natagoh/EE372B/ee372b-ldo-testbench/ee372b-ldo-testbench_20261005_030430/stencil_front.3mf

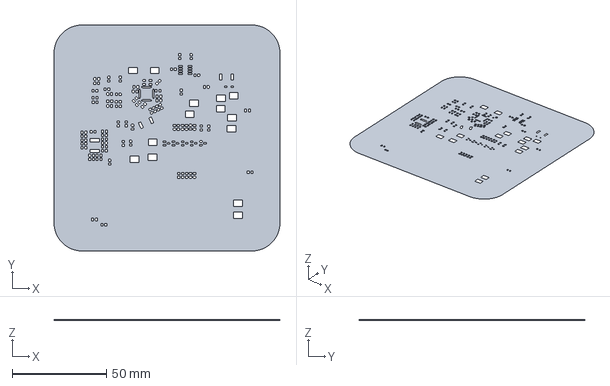
[picture p1: CAD file, 2026-10-05]
ee372b-ldo-testbench/ee372b-ldo-testbench_20261005_030430/stencil_front.3mf
120.0 x 120.0 x 0.2 mm
