natagoh/EE372B/parts/ADS1220IPW/ADS1220IPW.step

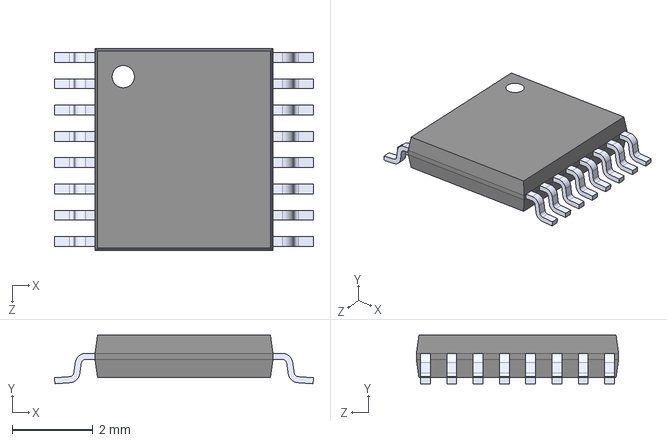
[picture p2: CAD file, 2026-10-04]
parts/ADS1220IPW/ADS1220IPW.step
6.40 x 1.20 x 5.00 mm
