natagoh/EE372B/parts/MMSZ4679T1G/SOD-123_ONS.step

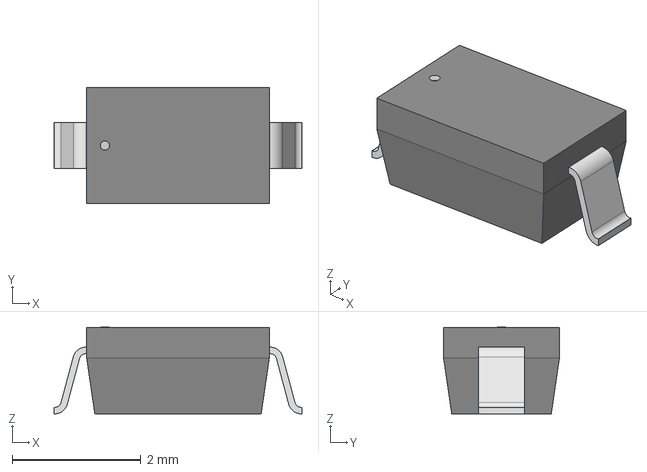
[picture p3: CAD file, 2026-10-04]
parts/MMSZ4679T1G/SOD-123_ONS.step
3.86 x 1.80 x 1.35 mm
