natagoh/EE372B/parts/PEC03SAAN/CONN_PEC03SAAN_SUL.step

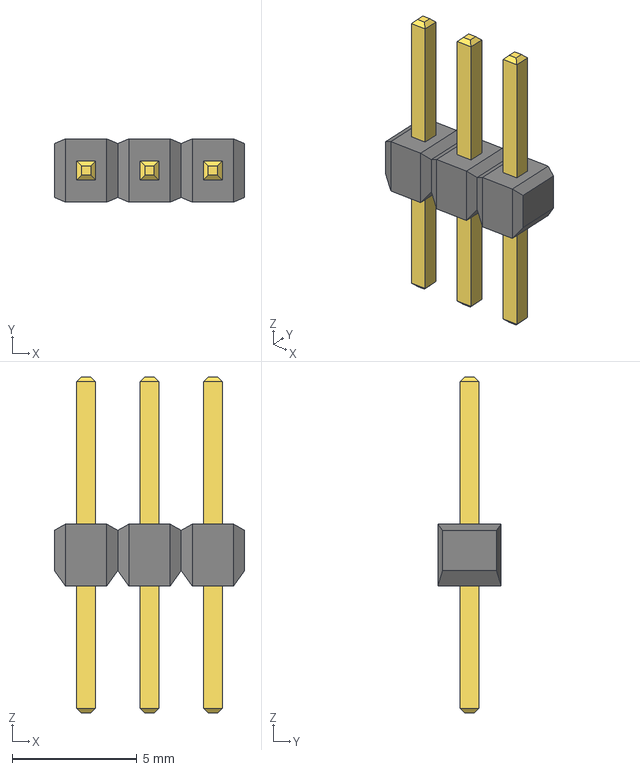
[picture p4: CAD file, 2026-10-04]
parts/PEC03SAAN/CONN_PEC03SAAN_SUL.step
7.62 x 2.54 x 13.5 mm
