natagoh/EE372B/(list of files, cad)

Other CAD files:
ee372b-ldo-testbench/stencil/ee372b-ldo-testbench_20261005_031027/stencil_front.3mf
ee372b-ldo-testbench/ee372b-ldo-testbench_20261005_030430/stencil_front.stl
ee372b-ldo-testbench/stencil/ee372b-ldo-testbench_20261005_031027/stencil_front.stl
