natagoh/EE372B/ee372b-ldo-testbench.pdf

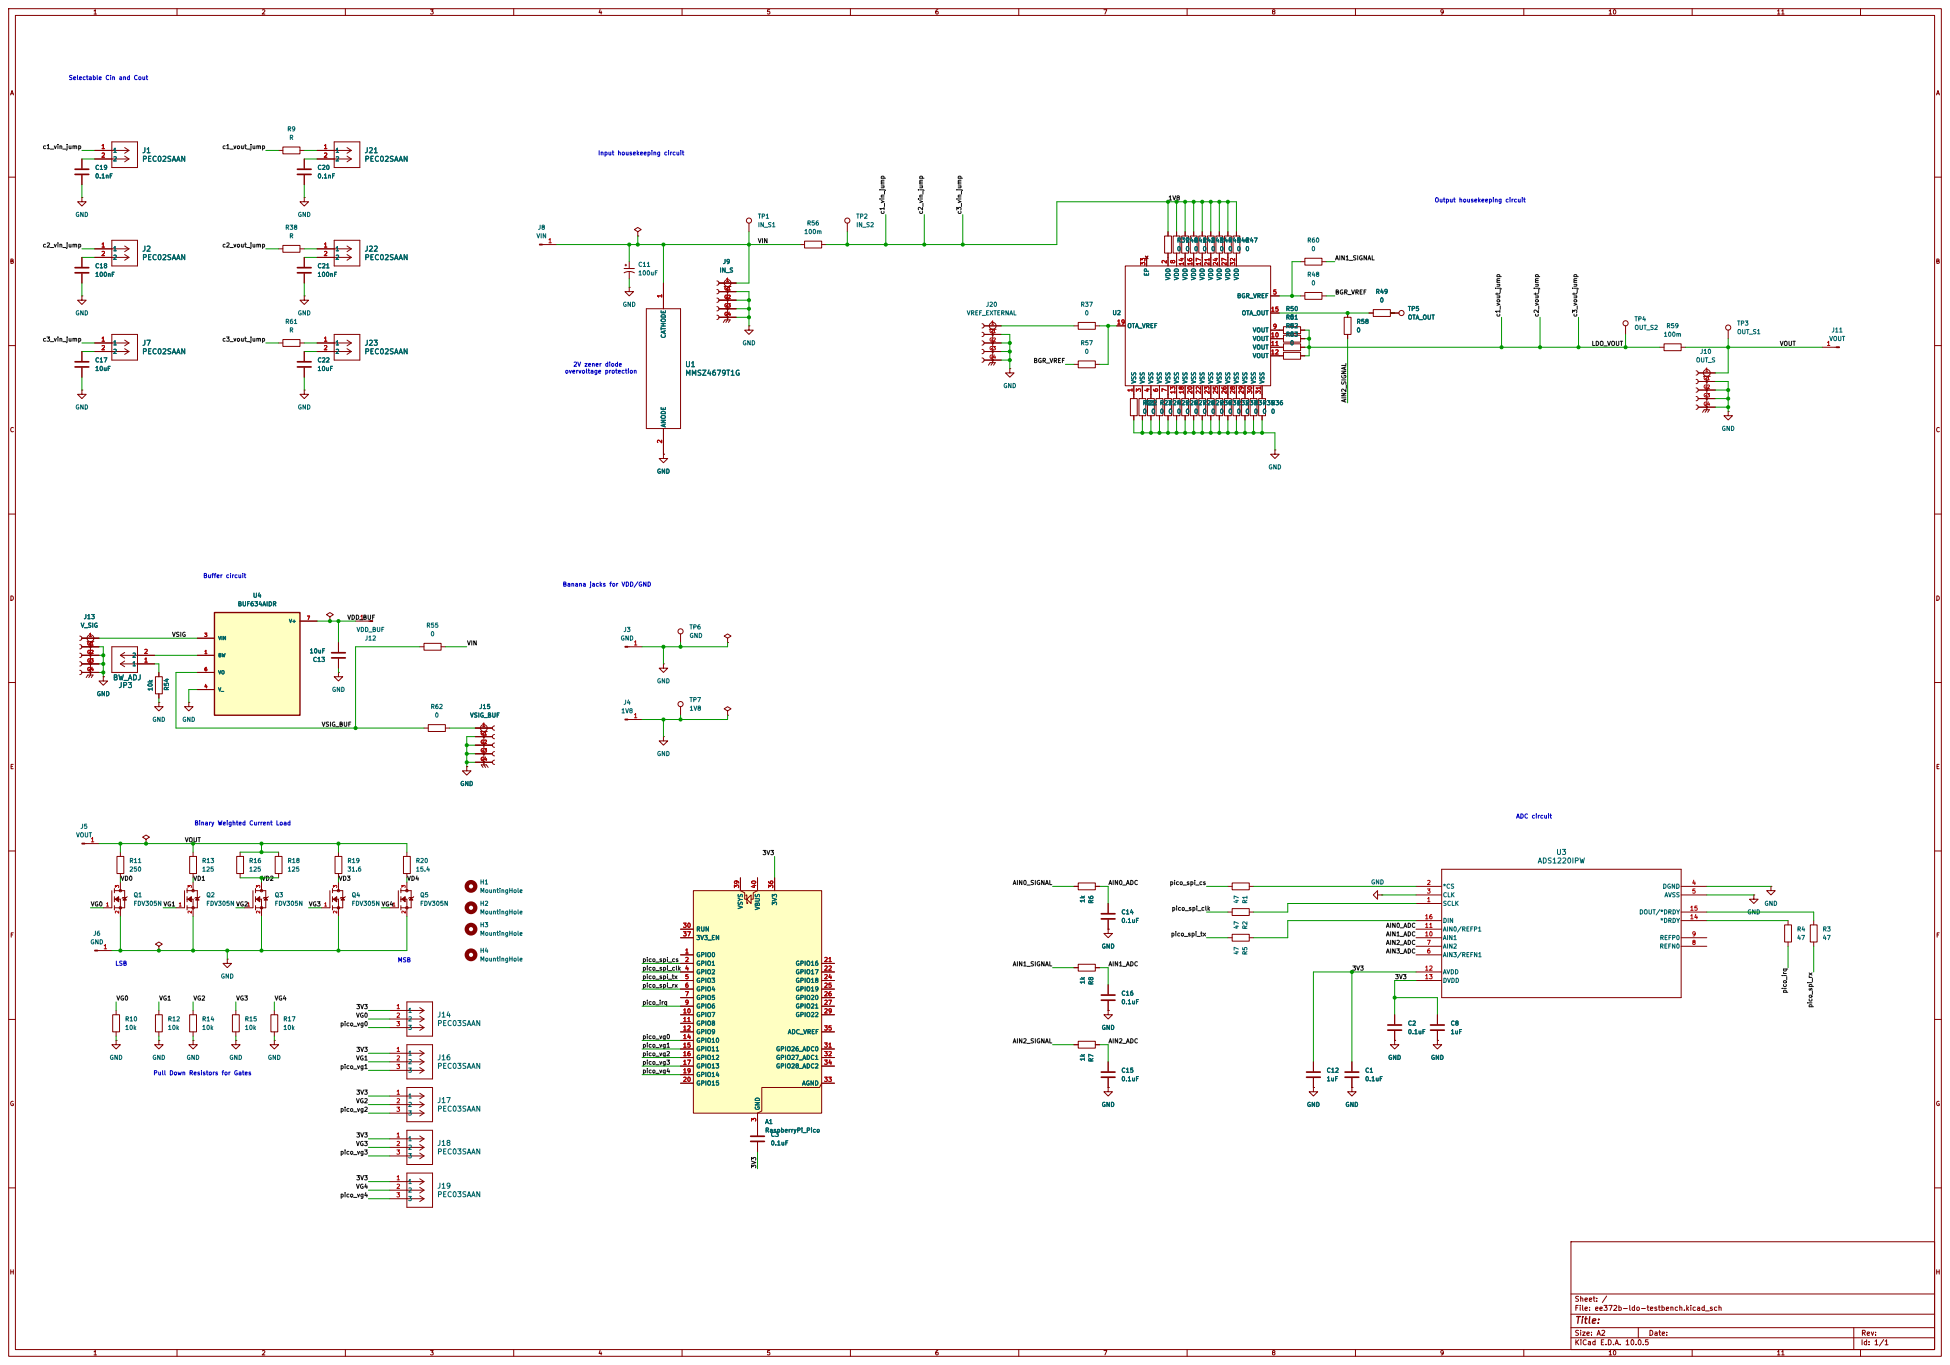
[picture p5: page 1]

Output housekeeping circuit Selectable Cin and Cout

2V zener diode overvoltage protection C19

Banana jacks for VDD/GND

3V3 Binary Weighted Current Load

Size: A2 | Rev:
KiCad E.D.A. 10.0.5 | Id: 1/1
