natagoh/EE372B/ee372b-ldo-testbench/ee372b-ldo-testbench.kicad_pcb

## KiCad design ee372b-ldo-testbench/ee372b-ldo-testbench.kicad_pcb (2026-11-07)

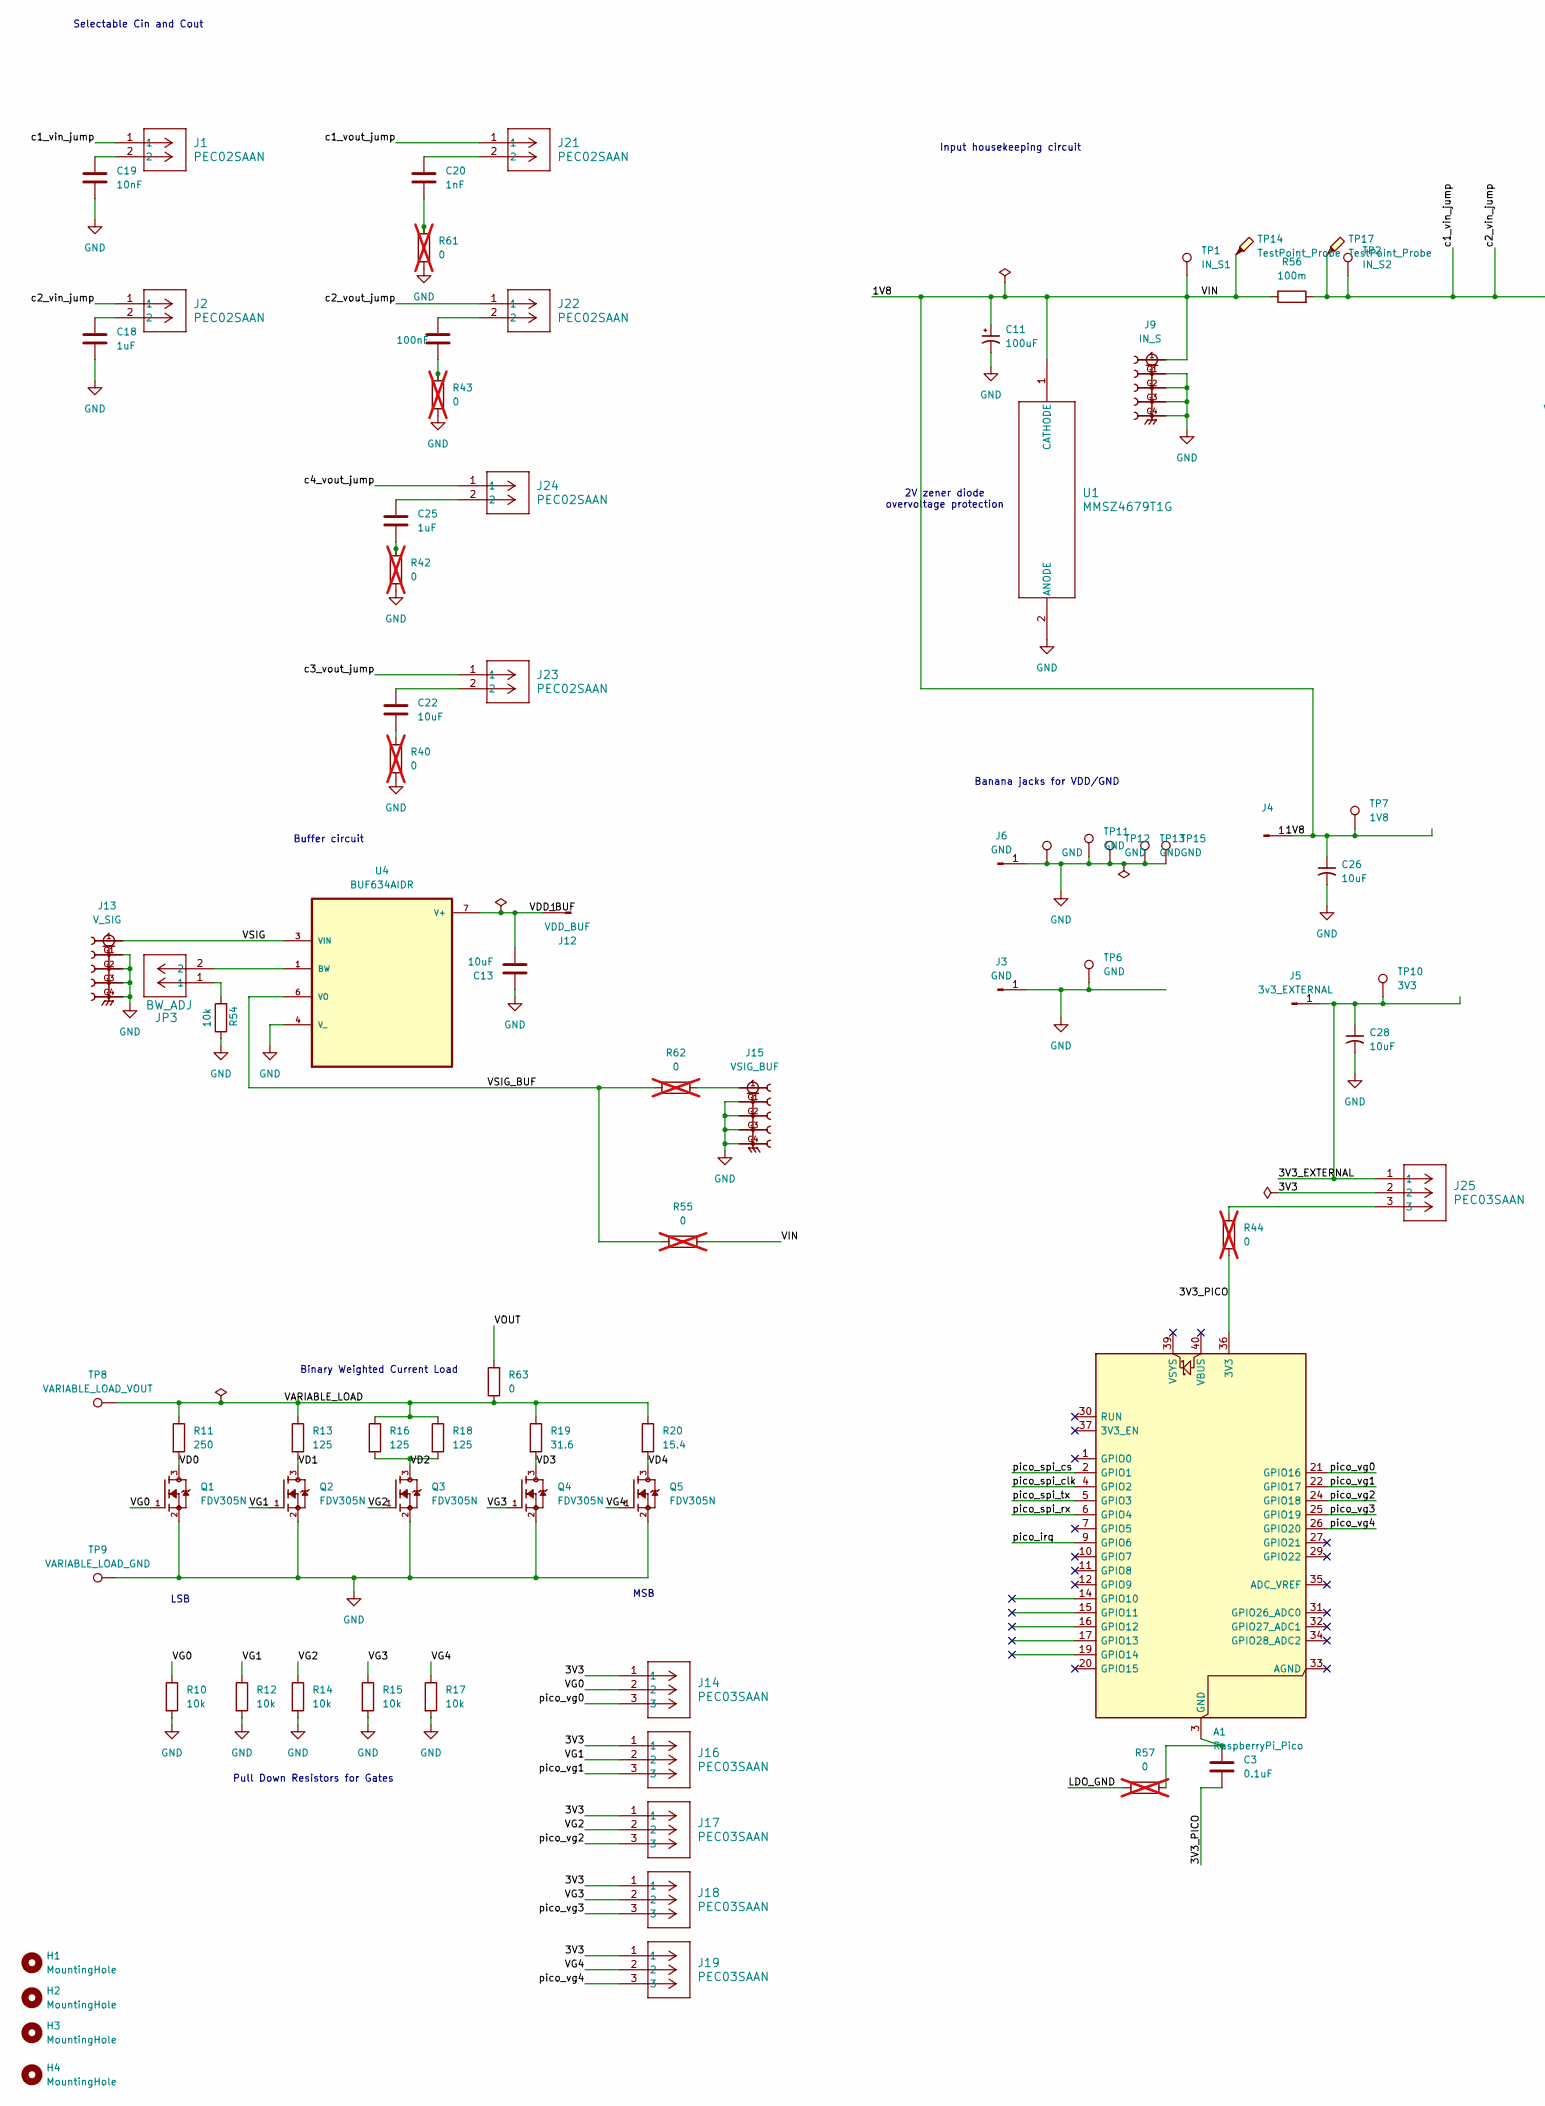
[picture p6: schematic ee372b-ldo-testbench.kicad_sch, part in row 1, column 1]

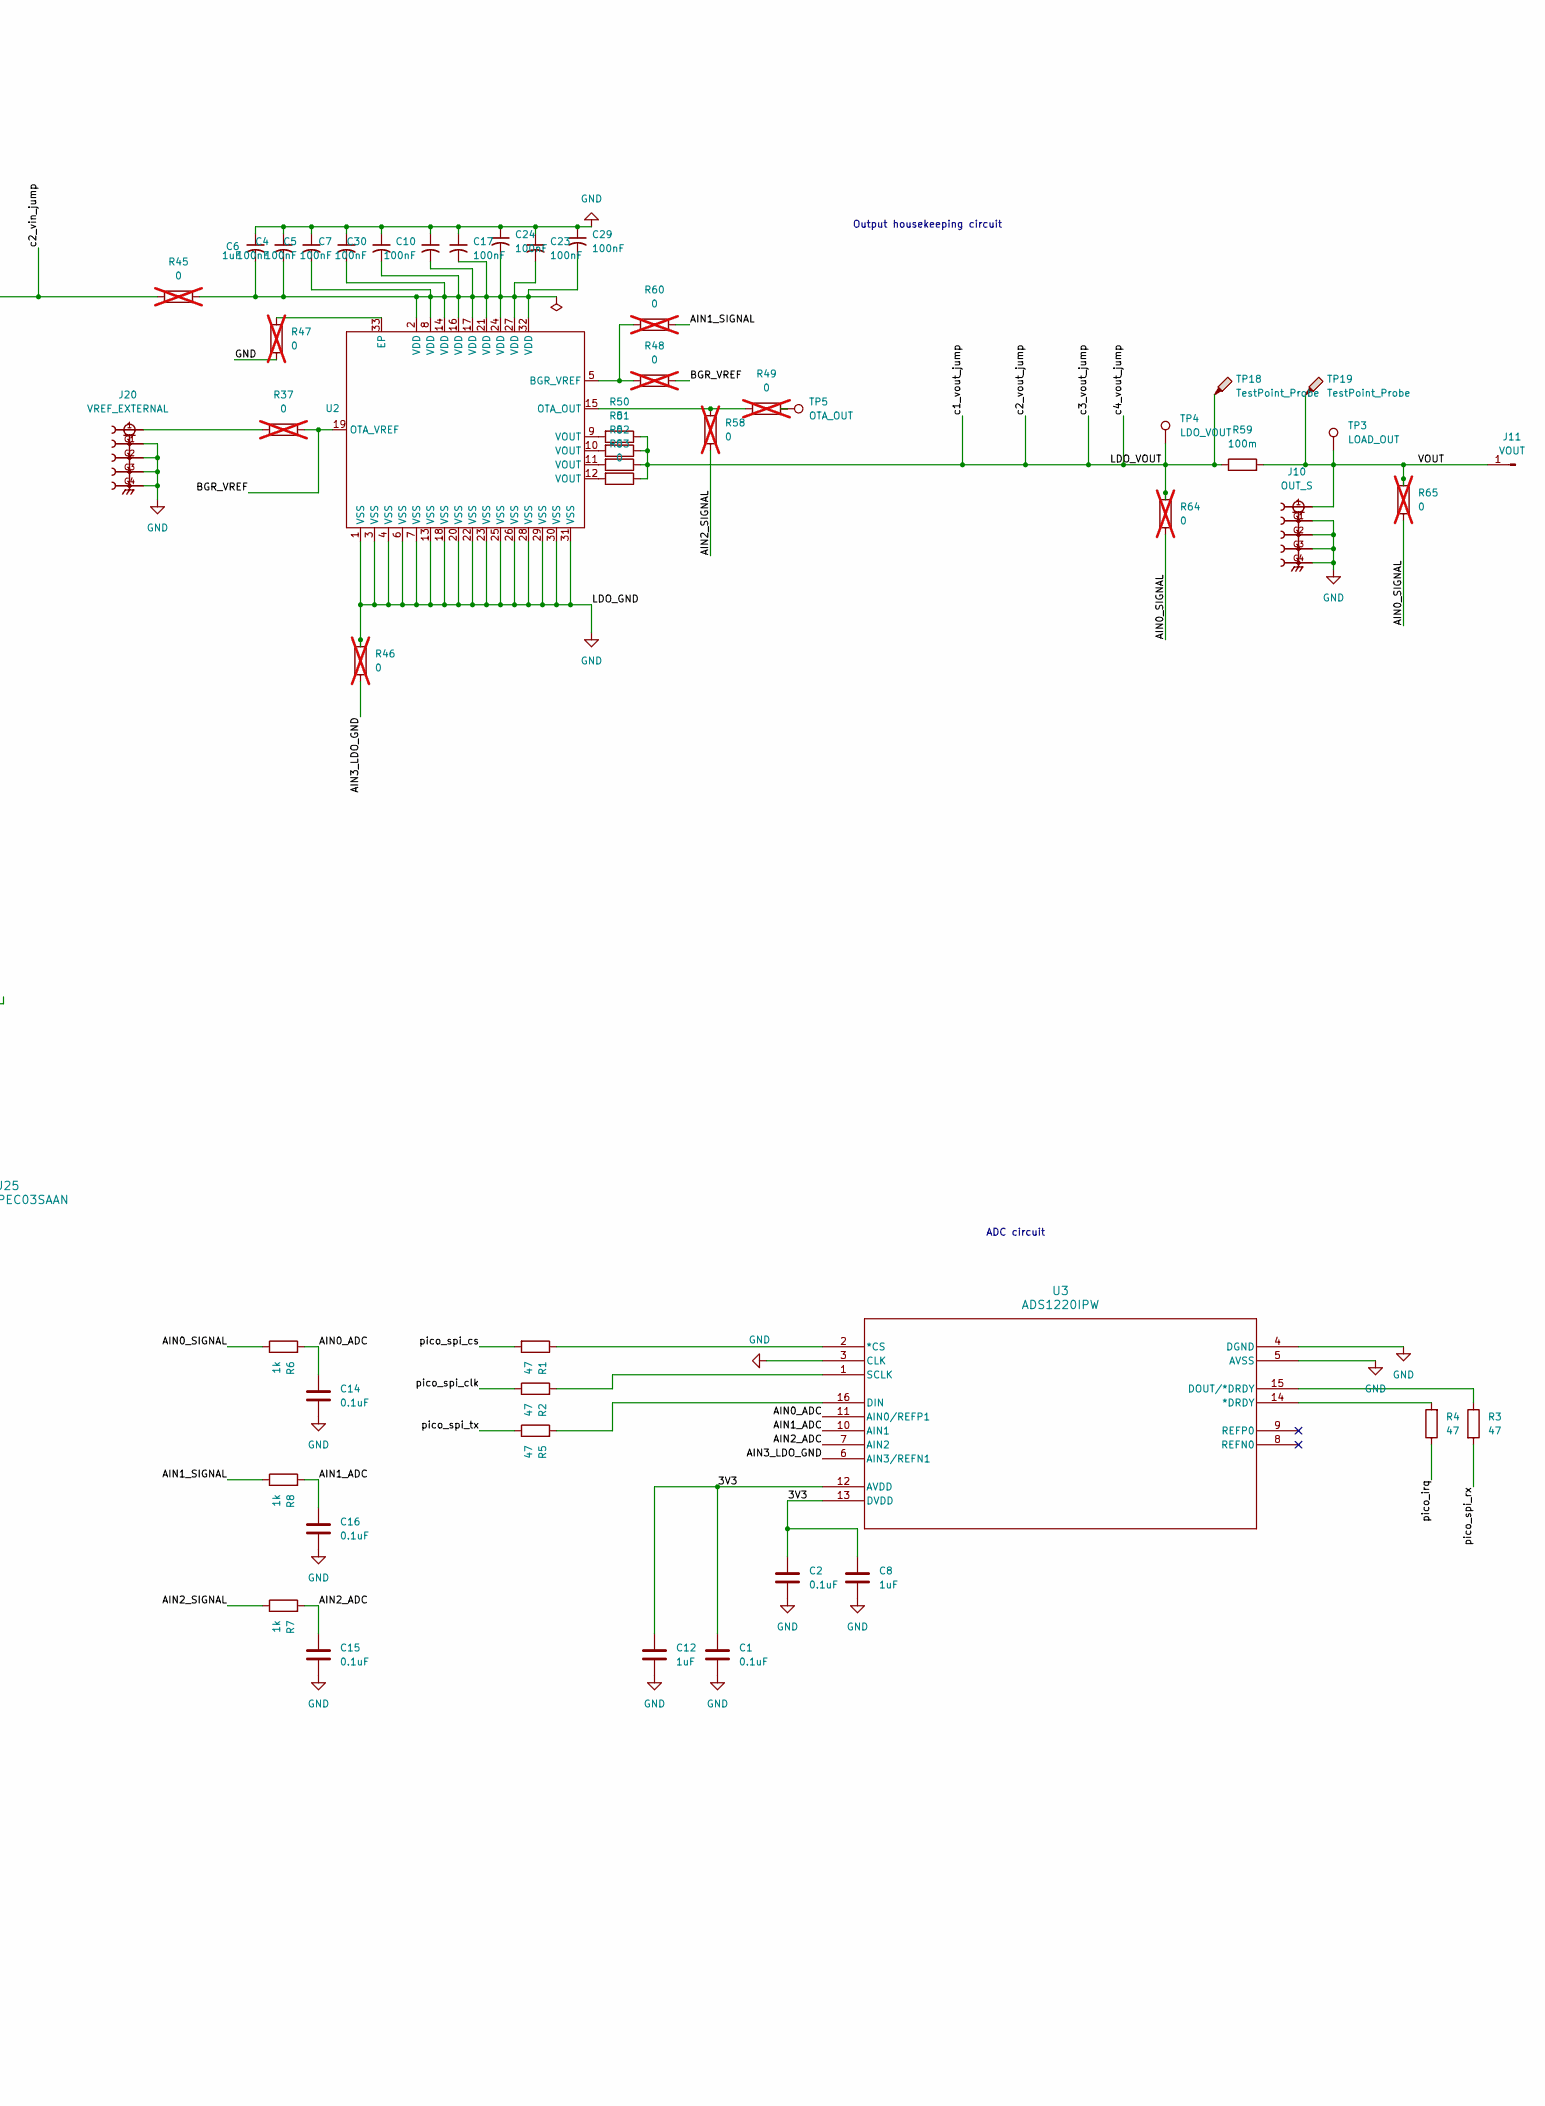
[picture p7: schematic ee372b-ldo-testbench.kicad_sch, part in row 1, column 2]

Parts:
A1: RaspberryPi_Pico; RaspberryPi_Pico_Common_Unspecified
C1, C2, C3, C14, C15, C16: 0.1uF; C_0805_2012Metric_Pad1.18x1.45mm_HandSolder
C4, C5, C7, C10, C17, C23, C24, C29, C30: 100nF; C_0805_2012Metric_Pad1.18x1.45mm_HandSolder
C6, C8, C12: 1uF; C_0805_2012Metric_Pad1.18x1.45mm_HandSolder
C11: 100uF; CAPPRD350W60D800H1150; Manufacturer Part Number EEU-FC1V101
C13, C22: 10uF; C_0805_2012Metric_Pad1.18x1.45mm_HandSolder; Manufacturer Part Number C0805C106K8RACTU
C18, C25: 1uF; C_0805_2012Metric_Pad1.18x1.45mm_HandSolder; Manufacturer Part Number C0805C104K8RACTU
C19: 10nF; C_0805_2012Metric_Pad1.18x1.45mm_HandSolder; Manufacturer Part Number C0805C101K8RACTU
C20: 1nF; C_0805_2012Metric_Pad1.18x1.45mm_HandSolder; Manufacturer Part Number C0805C101K8RACTU
C21: 100nF; C_0805_2012Metric_Pad1.18x1.45mm_HandSolder; Manufacturer Part Number C0805C104K8RACTU
C26, C28: 10uF; C_0805_2012Metric_Pad1.18x1.45mm_HandSolder
H1, H2, H3, H4: MountingHole; MountingHole_2.5mm
J1, J2, J21, J22, J23, J24: PEC02SAAN; CONN_PxC02S_SUL
J3, J6: GND; CALTEST_CT3151-2; Manufacturer Part Number CT3151SP-0
J4: 1V8; CALTEST_CT3151-2; Manufacturer Part Number CT3151SP-0
J5: 3v3_EXTERNAL; CALTEST_CT3151-2; Manufacturer Part Number CT3151SP-0
J9: IN_S; SAMTEC_SMA-J-P-H-ST-TH1; Manufacturer Part Number SMA-J-P-H-ST-TH1
J10: OUT_S; SAMTEC_SMA-J-P-H-ST-TH1; Manufacturer Part Number SMA-J-P-H-ST-TH1
J11: VOUT; CALTEST_CT3151-2; Manufacturer Part Number CT3151SP-6
J12: VDD_BUF; CALTEST_CT3151-2; Manufacturer Part Number CT3151SP-2
J13: V_SIG; SAMTEC_SMA-J-P-H-ST-TH1; Manufacturer Part Number SMA-J-P-H-ST-TH1
J14, J16, J17, J18, J19, J25: PEC03SAAN; CONN_PEC03SAAN_SUL
J15: VSIG_BUF; SAMTEC_SMA-J-P-H-ST-TH1; Manufacturer Part Number SMA-J-P-H-ST-TH1
J20: VREF_EXTERNAL; SAMTEC_SMA-J-P-H-ST-TH1; Manufacturer Part Number SMA-J-P-H-ST-TH1
JP3: BW_ADJ; CONN_PxC02S_SUL; Manufacturer Part Number PEC02SAAN
Q1, Q2, Q3, Q4, Q5: FDV305N; SOT95P240X111-3N; Manufacturer Part Number FDV305N
R1, R2, R3, R4, R5: 47; R_0805_2012Metric_Pad1.20x1.40mm_HandSolder
R6, R7, R8: 1k; R_0805_2012Metric_Pad1.20x1.40mm_HandSolder
R10, R12, R14, R15, R17, R54: 10k; R_0805_2012Metric_Pad1.20x1.40mm_HandSolder; Manufacturer Part Number RC0805FR-0710KL
R11: 250; R_0805_2012Metric_Pad1.20x1.40mm_HandSolder; Manufacturer Part Number RQ73C2A249RBTD
R13, R16, R18: 125; R_0805_2012Metric_Pad1.20x1.40mm_HandSolder; Manufacturer Part Number RQ73C2A124RBTD
R19: 31.6; R_0805_2012Metric_Pad1.20x1.40mm_HandSolder; Manufacturer Part Number RQ73C2A31R6BTD
R20: 15.4; R_0805_2012Metric_Pad1.20x1.40mm_HandSolder; Manufacturer Part Number RQ73C2A15R4BTDF
R37, R40, R42, R43, R44, R45, R46, R47, R48, R49, R58, R60, R61, R64, R65: 0; R_0805_2012Metric_Pad1.20x1.40mm_HandSolder; not fitted
R50, R51, R52, R53: 0; R_0805_2012Metric_Pad1.20x1.40mm_HandSolder
R55, R57, R62: 0; R_0805_2012Metric_Pad1.20x1.40mm_HandSolder; Manufacturer Part Number CRCW08050000Z0EAHP; not fitted
R56, R59: 100m; R_2512_6332Metric_Pad1.40x3.35mm_HandSolder; Manufacturer Part Number PA2512FKE7W0R1E
R63: 0; R_0805_2012Metric_Pad1.20x1.40mm_HandSolder; Manufacturer Part Number CRCW08050000Z0EAHP
TP1: IN_S1; KEYSTONE_5016; Manufacturer Part Number 5016
TP2: IN_S2; KEYSTONE_5016; Manufacturer Part Number 5016
TP3: LOAD_OUT; KEYSTONE_5016; Manufacturer Part Number 5016
TP4: LDO_VOUT; KEYSTONE_5016; Manufacturer Part Number 5016
TP5: OTA_OUT; KEYSTONE_5016; Manufacturer Part Number 5016
TP6, TP11, TP12, TP13, TP15, TP16: GND; KEYSTONE_5016; Manufacturer Part Number 5016
TP7: 1V8; KEYSTONE_5016; Manufacturer Part Number 5016
TP8: VARIABLE_LOAD_VOUT; KEYSTONE_5016; Manufacturer Part Number 5016
TP9: VARIABLE_LOAD_GND; KEYSTONE_5016; Manufacturer Part Number 5016
TP10: 3V3; KEYSTONE_5016; Manufacturer Part Number 5016
TP14, TP17, TP18, TP19: TestPoint_Probe; TestPoint_Pad_D1.0mm
U1: MMSZ4679T1G; SOD-123_ONS
U2: QFN-32_EP_7x7_Pitch0.65mm
U3: ADS1220IPW; PW16
U4: BUF634AIDR; SOIC127P599X175-8N; Manufacturer Part Number BUF634AIDR

Connections:
/3V3: C1.1, C2.1, C8.1, C12.1, J14.1, J16.1, J17.1, J18.1, J19.1, J25.2, U3.12 (AVDD), U3.13 (DVDD)
/3V3_EXTERNAL: C28.1, J5.1 (Pin_1_1), J25.1, TP10.1 (1_1)
/3V3_PICO: A1.36 (3V3), C3.2, R44.2
/AIN0_ADC: C14.1, R6.2, U3.11 (AIN0/REFP1)
/AIN0_SIGNAL: R6.1, R64.1, R65.1
/AIN1_ADC: C16.1, R8.2, U3.10 (AIN1)
/AIN1_SIGNAL: R8.1, R60.1
/AIN2_ADC: C15.1, R7.2, U3.7 (AIN2)
/AIN2_SIGNAL: R7.1, R58.1
/AIN3_LDO_GND: R46.1, U3.6 (AIN3/REFN1)
/BGR_VREF: R37.2, R48.1, U2.19 (OTA_VREF)
/LDO_VOUT: J21.1, J22.1, J23.1, J24.1, R50.1, R51.1, R52.1, R53.1, R59.1, R64.2, TP4.1 (1_1), TP18.1 (1_1)
/VARIABLE_LOAD: R11.1, R13.1, R16.1, R18.1, R19.1, R20.1, R63.1, TP8.1 (1_1)
/VD0: Q1.3, R11.2
/VD1: Q2.3, R13.2
/VD2: Q3.3, R16.2, R18.2
/VD3: Q4.3, R19.2
/VD4: Q5.3, R20.2
/VDD_BUF: C13.2, J12.1 (Pin_1_1), U4.7 (V+)
/VG0: J14.2, Q1.1, R10.1
/VG1: J16.2, Q2.1, R12.1
/VG2: J17.2, Q3.1, R14.1
/VG3: J18.2, Q4.1, R15.1
/VG4: J19.2, Q5.1, R17.1
/VOUT: J10.1, J11.1 (Pin_1_1), R59.2, R63.2, R65.2, TP3.1 (1_1), TP19.1 (1_1)
/VSIG: J13.1, U4.3 (VIN)
/VSIG_BUF: R55.1, R62.1, U4.6 (VO)
/c1_vin_jump: J1.1, J2.1, R45.1, R56.2, TP2.1 (1_1), TP17.1 (1_1)
/pico_irq: A1.9 (GPIO6), R4.1
/pico_spi_clk: A1.4 (GPIO2), R2.1
/pico_spi_cs: A1.2 (GPIO1), R1.2
/pico_spi_rx: A1.6 (GPIO4), R3.2
/pico_spi_tx: A1.5 (GPIO3), R5.1
/pico_vg0: A1.21 (GPIO16), J14.3
/pico_vg1: A1.22 (GPIO17), J16.3
/pico_vg2: A1.24 (GPIO18), J17.3
/pico_vg3: A1.25 (GPIO19), J18.3
/pico_vg4: A1.26 (GPIO20), J19.3
GND: C1.2, C2.2, C4.1, C5.1, C6.1, C7.1, C8.2, C10.1, C11.N, C12.2, C13.1, C14.2, C15.2, C16.2, C17.1, C18.2, C19.2, C23.1, C24.1, C26.2, C28.2, C29.1, C30.1, J3.1 (Pin_1_1), J6.1 (Pin_1_1), J9.G1, J9.G2, J9.G3, J9.G4, J10.G1, J10.G2, J10.G3, J10.G4, J13.G1, J13.G2, J13.G3, J13.G4, J15.G1, J15.G2, J15.G3, J15.G4, J20.G1, J20.G2, J20.G3, J20.G4, Q1.2, Q2.2, Q3.2, Q4.2, Q5.2, R10.2, R12.2, R14.2, R15.2, R17.2, R40.1, R42.1, R43.1, R46.2, R47.1, R54.1, R57.1, R61.1, TP6.1 (1_1), TP9.1 (1_1), TP11.1 (1_1), TP12.1 (1_1), TP13.1 (1_1), TP15.1 (1_1), TP16.1, U1.2 (ANODE), U2.1 (VSS), U2.3 (VSS), U2.4 (VSS), U2.6 (VSS), U2.7 (VSS), U2.13 (VSS), U2.18 (VSS), U2.20 (VSS), U2.22 (VSS), U2.23 (VSS), U2.25 (VSS), U2.26 (VSS), U2.28 (VSS), U2.29 (VSS), U2.30 (VSS), U2.31 (VSS), U3.3 (CLK), U3.4 (DGND), U3.5 (AVSS), U4.4 (V_); also elsewhere on the board
unnamed: A1.3 (GND), A1.8 (GND), A1.13 (GND), A1.18 (GND), A1.23 (GND), A1.28 (GND), A1.38 (GND), C3.1, R57.2
unnamed: C4.2, C5.2, C6.2, C7.2, C10.2, C17.2, C23.2, C24.2, C29.2, C30.2, R45.2, U2.2 (VDD), U2.8 (VDD), U2.14 (VDD), U2.16 (VDD), U2.17 (VDD), U2.21 (VDD), U2.24 (VDD), U2.27 (VDD), U2.32 (VDD)
unnamed: C18.1, J2.2
unnamed: C19.1, J1.2
unnamed: C20.1, J21.2
unnamed: C20.2, R61.2
unnamed: C21.1, J22.2
unnamed: C21.2, R43.2
unnamed: C22.1, J23.2
unnamed: C22.2, R40.2
unnamed: C25.1, J24.2
unnamed: C25.2, R42.2
unnamed: J15.1, R62.2
unnamed: J20.1, R37.1
unnamed: J25.3, R44.1
unnamed: JP3.1, R54.2
unnamed: R49.1, TP5.1 (1_1)
unnamed: R50.2, U2.9 (VOUT)
unnamed: R51.2, U2.10 (VOUT)
unnamed: R52.2, U2.11 (VOUT)
unnamed: R53.2, U2.12 (VOUT)
unnamed: R48.2, R60.2, U2.5 (BGR_VREF)
unnamed: R47.2, U2.33 (EP)
unnamed: R49.2, R58.2, U2.15 (OTA_OUT)
unnamed: R1.1, U3.2 (*CS)
unnamed: R4.2, U3.14 (*DRDY)
unnamed: R5.2, U3.16 (DIN)
unnamed: R3.1, U3.15 (DOUT/*DRDY)
unnamed: R2.2, U3.1 (SCLK)
unnamed: JP3.2, U4.1 (BW)

Notes on the sheet:
LSB
Banana jacks for VDD/GND
Binary Weighted Current Load
Selectable Cin and Cout
Pull Down Resistors for Gates
2V zener diode overvoltage protection
Input housekeeping circuit
MSB
Output housekeeping circuit
Buffer circuit
ADC circuit

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
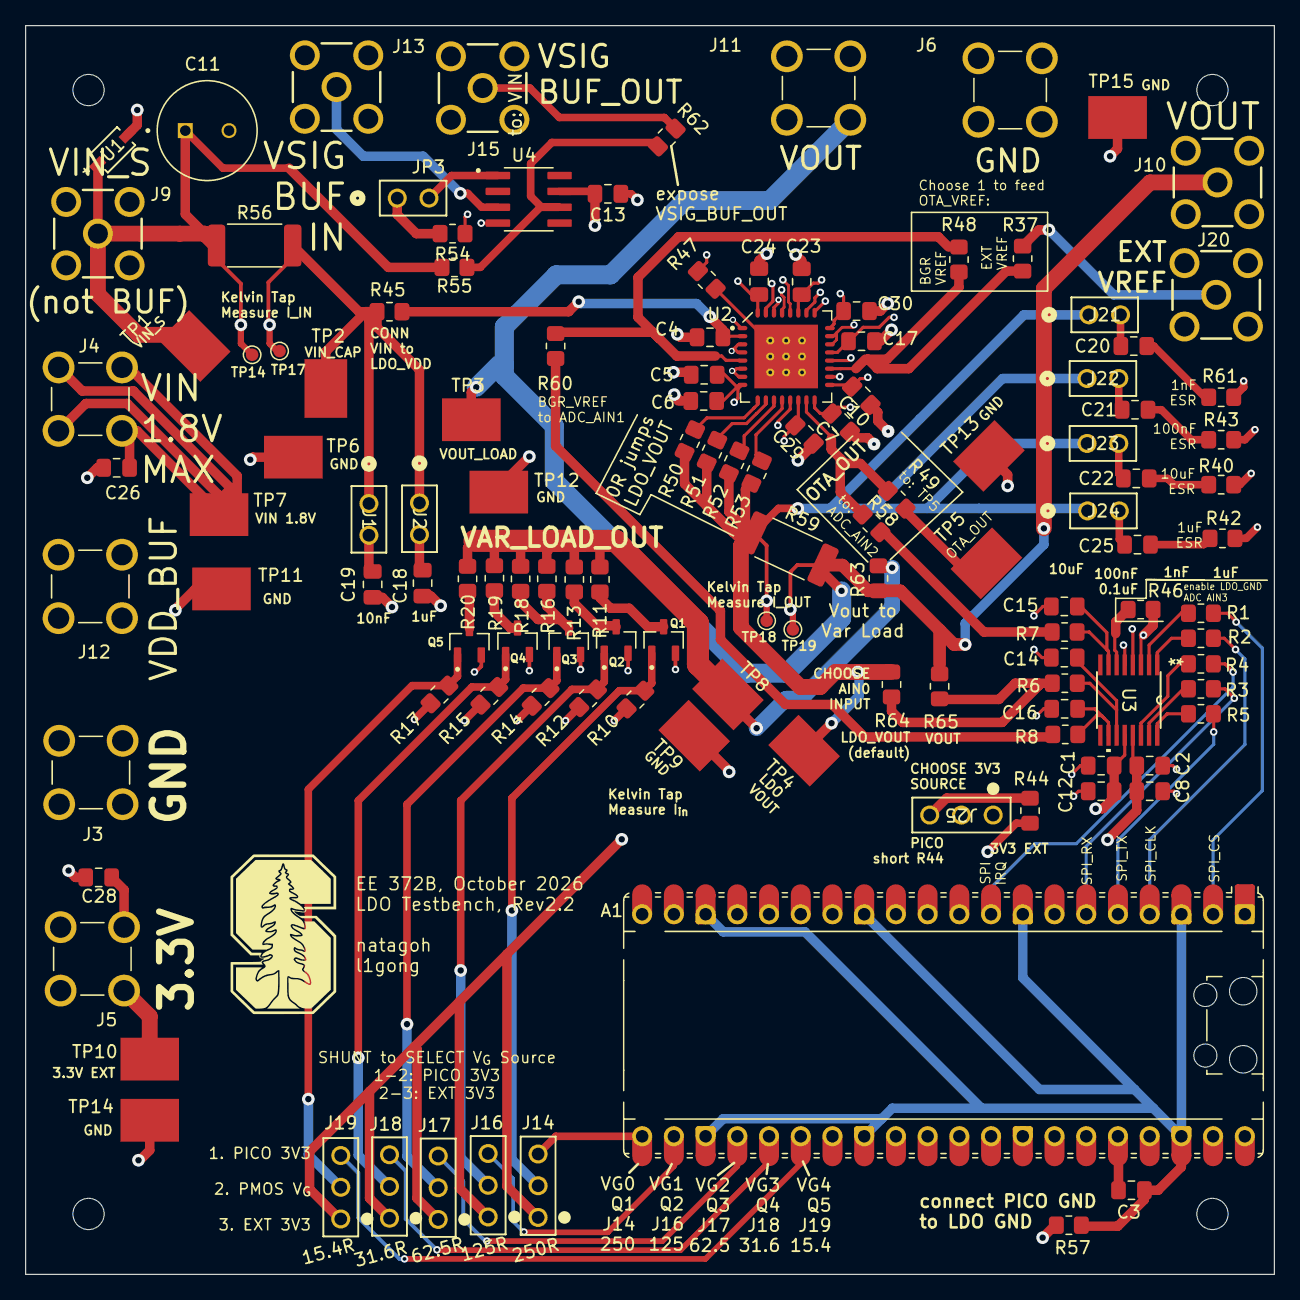
[picture p8: board ee372b-ldo-testbench.kicad_pcb from above]

Board: 4 copper layers, 100.0 x 100.0 mm, 130 parts (0 on the bottom side), 71 nets.

Other parts of the board:
TP14#2: GND; KEYSTONE_5016

Their connections:
GND: TP14#2.1 (1_1); also elsewhere on the board
