natagoh/EE372B/(commit log)

2026-09-29 starter files
    [ee372b-ldo-testbench.kicad_pcb, ee372b-ldo-testbench.kicad_sch]
2026-09-29 add initial qfn footprint - no pad labels yet
2026-10-02 started ldo testbench schematic
2026-10-03 initial schematic
    [ee372b-ldo-testbench.kicad_sch]
2026-10-04 added parts folder, schematic v2
    [ADS1220IPW.step, ee372b-ldo-testbench.kicad_sch]
2026-10-04 connected load bank to vout
    [ee372b-ldo-testbench.kicad_sch]
2026-10-04 add demo board symbols + footprints
    [ee372b-ldo-testbench.kicad_sch]
2026-10-04 finished initial testbench?
    [CONN_PEC03SAAN_SUL.step, ee372b-ldo-testbench.kicad_sch]
2026-10-04 add MMSZ4679T1G zener diode symbol, footprint
    [SOD-123_ONS.step, ee372b-ldo-testbench.kicad_sch]
2026-10-04 passes ERC
    [ee372b-ldo-testbench.kicad_sch]
2026-10-04 passes ERC, all footprints assigned
    [ee372b-ldo-testbench.kicad_pcb, ee372b-ldo-testbench.kicad_sch]
2026-10-04 updated pcb layout settings to 4 layers
    [ee372b-ldo-testbench.kicad_pcb, ee372b-ldo-testbench.kicad_sch]
2026-10-04 tweaks to schematic, more bypass caps, ext 3v3 source
    [ee372b-ldo-testbench.kicad_pcb, ee372b-ldo-testbench.kicad_sch]
2026-10-04 adding footprints
    [ee372b-ldo-testbench.kicad_sch]
2026-10-04 tried to group things together
    [ee372b-ldo-testbench.kicad_pcb]
2026-10-04 updated QFN courtyard
    [ee372b-ldo-testbench.kicad_pcb, ee372b-ldo-testbench.kicad_sch]
2026-10-04 reduced pin bypass caps
    [ee372b-ldo-testbench.kicad_pcb, ee372b-ldo-testbench.kicad_sch]
2026-10-04 added 100mm x 100mm thing
    [ee372b-ldo-testbench.kicad_pcb, ee372b-ldo-testbench.kicad_sch]
2026-10-05 added selectable output for ADC Analog3 pin measurement for VOUT
    [ee372b-ldo-testbench.kicad_pcb, ee372b-ldo-testbench.kicad_sch]
2026-10-05 omg fit everything in 100x100
    [ee372b-ldo-testbench.kicad_pcb]
2026-10-05 re add caps for each pin
    [ee372b-ldo-testbench.kicad_pcb, ee372b-ldo-testbench.kicad_sch]
2026-10-05 added more GND test points and EP to VSS r0 thing
    [ee372b-ldo-testbench.kicad_pcb, ee372b-ldo-testbench.kicad_sch]
2026-10-05 first plane fill on L2 GND
    [ee372b-ldo-testbench.kicad_pcb, ee372b-ldo-testbench.kicad_sch]
2026-10-05 fixed kicad net name for pin 19
    [ee372b-ldo-testbench.kicad_pcb, ee372b-ldo-testbench.kicad_sch]
2026-10-05 connected ADC PICO
    [ee372b-ldo-testbench.kicad_pcb]
2026-10-05 resistor bank wired
    [ee372b-ldo-testbench.kicad_pcb]
2026-10-05 fixed last ERC issues
    [ee372b-ldo-testbench.kicad_sch]
2026-10-05 omg cleared DRC
    [ee372b-ldo-testbench.kicad_pcb, ee372b-ldo-testbench.kicad_sch, untitled.kicad_sch]
2026-10-05 last sanity check DRC ERC
    [ee372b-ldo-testbench.kicad_pcb]
2026-10-05 added stencil and BOM
    [stencil_front.3mf, stencil_front.stl]
2026-10-05 made stencil folder
    [stencil_front.3mf, stencil_front.stl]
2026-10-05 updated labels, added names
    [ee372b-ldo-testbench.kicad_pcb]
2026-10-07 fixing PCB
    [ee372b-ldo-testbench-B_Cu.gbr, ee372b-ldo-testbench-B_Mask.gbr, ee372b-ldo-testbench-B_Paste.gbr, ee372b-ldo-testbench-B_Silkscreen.gbr, ee372b-ldo-testbench-Edge_Cuts.gbr, ee372b-ldo-testbench-F_Cu.gbr, ee372b-ldo-testbench-F_Mask.gbr, ee372b-ldo-testbench-F_Paste.gbr]
2026-10-07 otuput bank traces thicker
    [ee372b-ldo-testbench.kicad_pcb, ee372b-ldo-testbench.kicad_sch]
2026-10-07 finished thcicker traces whole board
    [ee372b-ldo-testbench.kicad_pcb, ee372b-ldo-testbench.kicad_sch]
2026-10-07 DRC clean
    [ee372b-ldo-testbench-B_Cu.gbr, ee372b-ldo-testbench-B_Mask.gbr, ee372b-ldo-testbench-B_Paste.gbr, ee372b-ldo-testbench-B_Silkscreen.gbr, ee372b-ldo-testbench-Edge_Cuts.gbr, ee372b-ldo-testbench-F_Cu.gbr, ee372b-ldo-testbench-F_Mask.gbr, ee372b-ldo-testbench-F_Paste.gbr]
2026-10-07 emailed to TAs
    [ee372b-ldo-testbench-B_Cu.gbr, ee372b-ldo-testbench-B_Mask.gbr, ee372b-ldo-testbench-B_Paste.gbr, ee372b-ldo-testbench-B_Silkscreen.gbr, ee372b-ldo-testbench-Edge_Cuts.gbr, ee372b-ldo-testbench-F_Cu.gbr, ee372b-ldo-testbench-F_Mask.gbr, ee372b-ldo-testbench-F_Paste.gbr]
2026-10-09 forgot drill files last time
    [ee372b-ldo-testbench-B_Cu.gbr, ee372b-ldo-testbench-B_Mask.gbr, ee372b-ldo-testbench-B_Paste.gbr, ee372b-ldo-testbench-B_Silkscreen.gbr, ee372b-ldo-testbench-Edge_Cuts.gbr, ee372b-ldo-testbench-F_Cu.gbr, ee372b-ldo-testbench-F_Mask.gbr, ee372b-ldo-testbench-F_Paste.gbr]
2026-10-09 gerbers and drills
    [ee372b-ldo-testbench-B_Cu.gbr, ee372b-ldo-testbench-B_Mask.gbr, ee372b-ldo-testbench-B_Paste.gbr, ee372b-ldo-testbench-B_Silkscreen.gbr, ee372b-ldo-testbench-Edge_Cuts.gbr, ee372b-ldo-testbench-F_Cu.gbr, ee372b-ldo-testbench-F_Mask.gbr, ee372b-ldo-testbench-F_Paste.gbr]
2026-10-09 final submitted
    [ee372b-ldo-testbench.kicad_sch]
2026-11-07 add pico micropython code
2026-11-07 fixed pcb silkscreen mislabels
